yuqlid/MotorBench_board/stp/c-282834-8-c-3d.stp

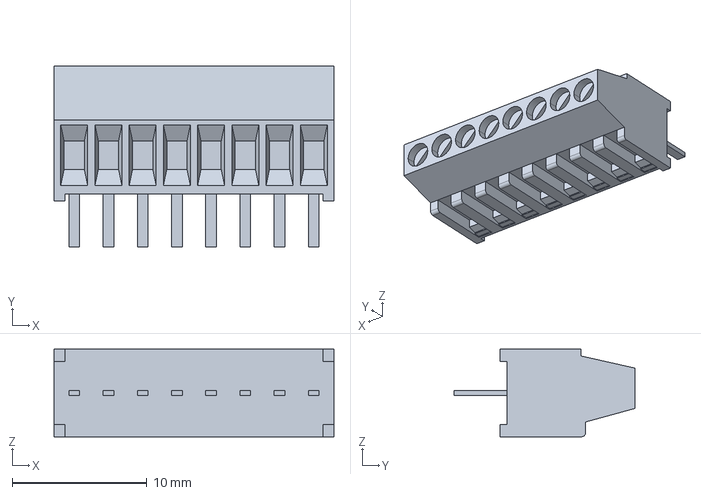
[picture p1: CAD file, 2020-02-05]
stp/c-282834-8-c-3d.stp
20.8 x 13.4 x 6.50 mm
