yuqlid/MotorBench_board/Encoder_check.kicad_pcb

## KiCad design Encoder_check.kicad_pcb (2020-04-29)

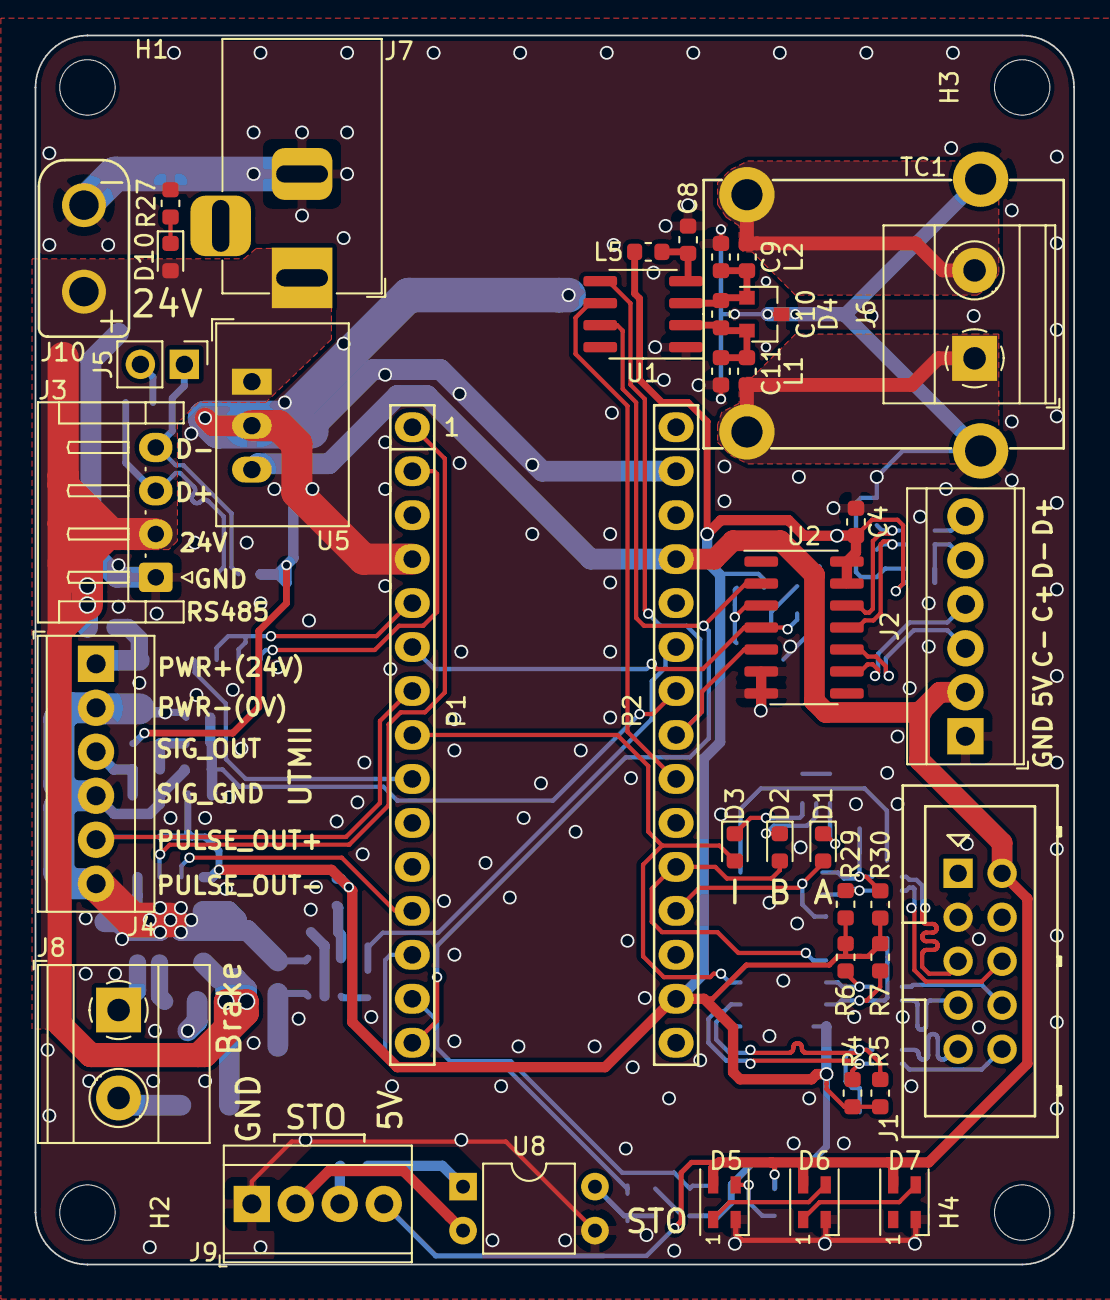
[picture p2: board Encoder_check.kicad_pcb from above]

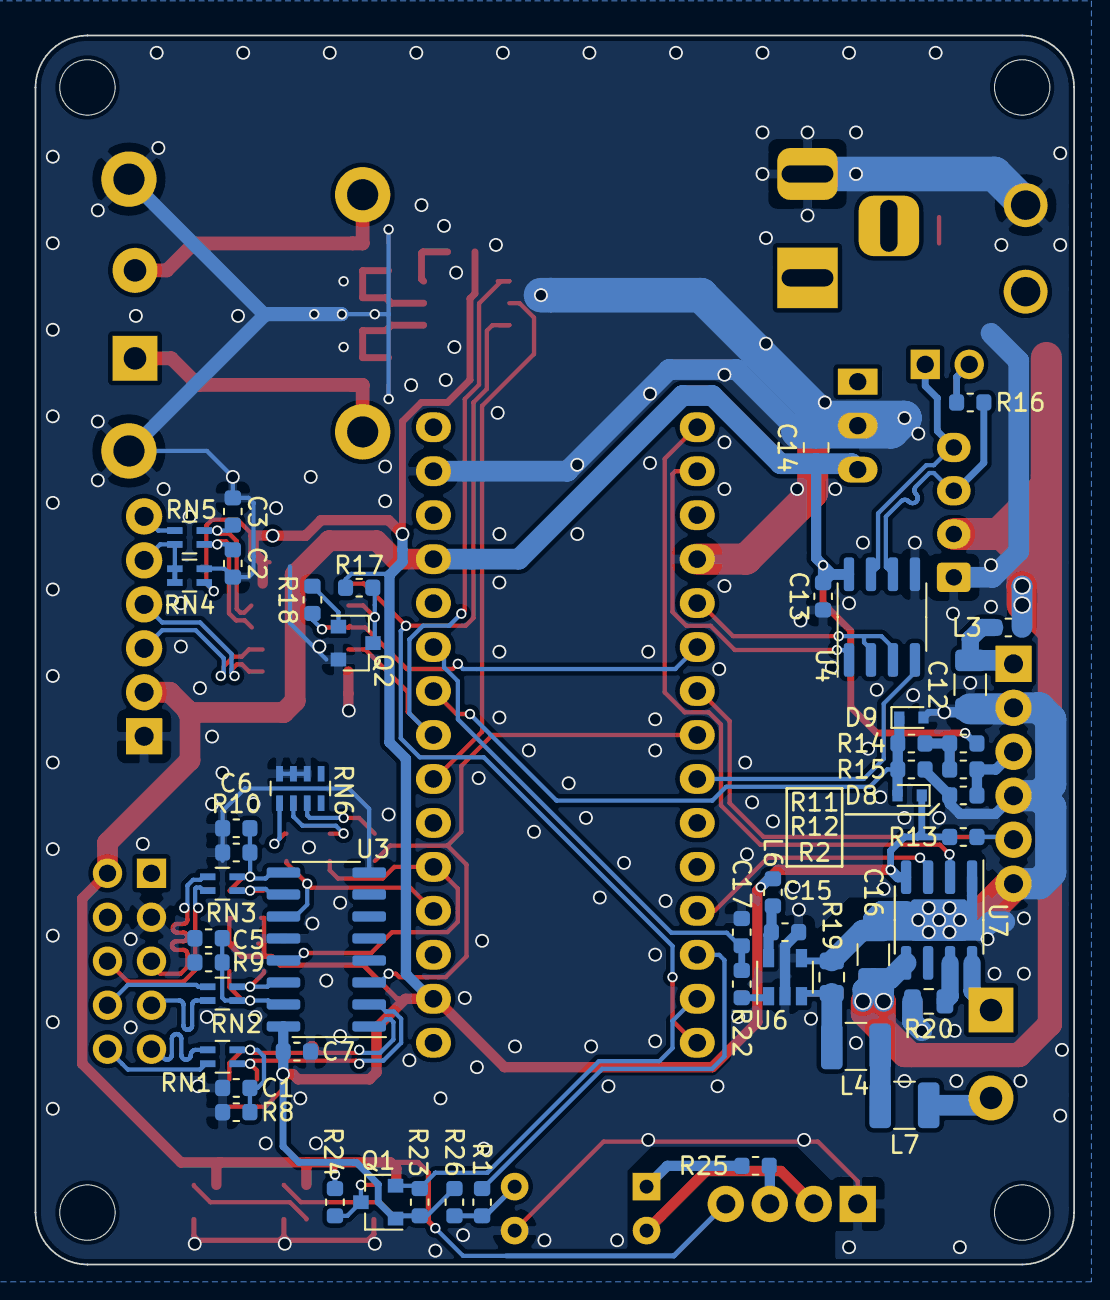
[picture p3: board Encoder_check.kicad_pcb from below]

Board: 2 copper layers, 60.0 x 71.0 mm, 94 parts (50 on the bottom side), 71 nets.

Parts:
C1, C2, C3, C5, C6: 220p; C_0603_1608Metric
C4, C7, C8, C13, C15, C17: 0.1u; C_0603_1608Metric
C9, C11: DNP; C_0603_1608Metric
C10: 10n; C_0603_1608Metric
C12: C; C_1206_3216Metric
C14: 3.3u; C_0805_2012Metric
C16: 1u; C_1206_3216Metric
D1, D2, D3, D10: LED; LED_0603_1608Metric
D4: D_TVS_x2_AAC; SOT-23
D5, D6, D7: SK6805; LED_SK6805_PLCC4_2.4x2.7mm_P1.3mm
D8, D9: D; D_SOD-523
H1, H2, H3, H4: MountingHole; MountingHole_3.2mm_M3
J1: Conn_02x05_Odd_Even; Multicomp_MC9A12-1034_2x05_P2.54mm_Vertical
J2, J4: Screw_Terminal_01x06; TerminalBlock_TE_282834-6_1x06_P2.54mm_Horizontal
J3: Conn_01x04; JST_EH_S4B-EH_1x04_P2.50mm_Horizontal
J5: Conn_01x02; PinHeader_1x02_P2.54mm_Vertical
J6, J8: Screw_Terminal_01x02; TerminalBlock_Phoenix_MKDS-1,5-2-5.08_1x02_P5.08mm_Horizont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
J7: Barrel_Jack_Switch; BarrelJack_Horizontal
J9: Screw_Terminal_01x04; TerminalBlock_TE_282834-4_1x04_P2.54mm_Horizontal
J10: Conn_01x02; XT30PB
L1, L2, L3, L5, L6: L; L_0603_1608Metric
L4, L7: L; L_1210_3225Metric
P1: Digital; Socket_Strip_Arduino_1x15
P2: Analog; Socket_Strip_Arduino_1x15
Q1, Q2: BSS138; SOT-23
R1, R13, R18, R25: 1k; R_0603_1608Metric
R2, R4, R6, R11, R12, R14, R15, R17, R23, R24, R26, R29: 10k; R_0603_1608Metric
R5, R7, R8, R9, R10, R27, R30: 20k; R_0603_1608Metric
R16: 120; R_0603_1608Metric
R19: 0.05; L_0805_2012Metric
R20: 0; L_0805_2012Metric
R22: 100; L_0603_1608Metric
RN1, RN2, RN3, RN5: 150; R_Array_Concave_2x0603
RN4: 4.7k; R_Array_Concave_2x0603
RN6: 1k; R_Array_Concave_4x0603
TC1: Thermocouple_PCB; Omega_PCC-SMP_1x2_P13.70mm_Horizontal
U1: MAX31855KASA; SOIC-8_3.9x4.9mm_P1.27mm
U2: ISL83491; SOIC-14_3.9x8.7mm_P1.27mm
U3: AM26LV32xD; SOIC-16_3.9x9.9mm_P1.27mm
U4: ST485BDR; SOIC-8_3.9x4.9mm_P1.27mm
U5: M78AR05-1; Converter_DCDC_MINIMAX_M78AR05-1_THT
U6: INA180A; SOT-23-5
U7: A4953_LJ; SOIC-8-1EP_3.9x4.9mm_P1.27mm_EP2.41x3.3mm
U8: TLP785; DIP-4_W7.62mm

Connections:
+3V3: C4.1, C7.1, D8.1, L5.1, L6.1, P2.14, Q1.1, R4.1, R5.1, R6.1, R7.1, R13.2, R17.2, R23.1, R26.1, R29.1, R30.1, RN4.3, U2.13, U2.14, U3.16, U7.4
+5V: C13.1, C14.1, D5.4, D6.4, D7.4, J1.2, J2.2, J9.4, P2.4, R11.1, R24.1, U4.8, U5.3
+24V: C16.1, D10.2, J3.2, J7.1, J10.1, L3.2, U5.1, U7.5
/0(Rx): P1.2, U4.1
/1(Tx): P1.1, U7.2
/2: P1.5, U4.2, U4.3
/3(**): P1.6, R18.1, U2.4
/4: J4.5, P1.7, R13.1
/5(**): D3.2, P1.8, U3.3
/6(**): P1.9, U4.4
/9(**): P1.12, U7.3
/10(**/SS): P1.13, R1.1
/11(**/MOSI): P1.14, Q1.2, R23.2
/12(MISO): P1.15, U1.7, U2.2
/A0: D1.2, P2.12, U3.11
/A1: D2.2, P2.11, U3.13
/A3: P2.9, U1.6
/A4: P2.8, U1.5, U2.5
/A5: D8.2, D9.1, P2.7, R14.1, R15.2
/A6: C17.1, P2.6, R22.1
/Reset: P1.3, P2.3
/brake/brake_+: J8.1, U7.8
/brake/brake_-: J8.2, L7.1
/inc_encoder/A+: J1.6, RN3.4
/inc_encoder/A-: J1.5, RN3.3
/inc_encoder/A_+: R29.2, RN3.1, U3.10
/inc_encoder/A_-: C6.1, R10.1, R30.2, RN3.2, U3.9
/inc_encoder/B+: J1.8, RN2.3
/inc_encoder/B-: J1.7, RN2.4
/inc_encoder/B_+: R6.2, RN2.2, U3.14
/inc_encoder/B_-: C5.1, R7.2, R9.1, RN2.1, U3.15
/inc_encoder/I+: J1.10, RN1.4
/inc_encoder/I-: J1.9, RN1.3
/inc_encoder/I_+: R4.2, RN1.1, U3.2
/inc_encoder/I_-: C1.1, R5.2, R8.1, RN1.2, U3.1
/rs485/RS485_+: J3.3, R16.2, U4.6
/rs485/RS485_-: J3.4, J5.1, U4.7
/ssi_encoder/C_+: J2.4, U2.9
/ssi_encoder/C_-: J2.3, U2.10
/ssi_encoder/D_+: J2.6, RN5.3
/ssi_encoder/D_-: J2.5, RN4.1, RN4.2, RN5.4
/ssi_encoder/Dout_+: C3.1, RN5.2, U2.12
/ssi_encoder/Dout_-: C2.1, RN5.1, U2.11
/thermocouple/T+: J6.2, L2.1, TC1.1
/thermocouple/T-: J6.1, L1.1, TC1.2
/utm/PWR+(24V): C12.1, J4.1, L3.1
/utm/SIG_OUT: J4.3, R2.2, R12.1
GND: C1.2, C2.2, C3.2, C4.2, C5.2, C6.2, C7.2, C8.2, C9.1, C11.2, C12.2, C13.2, C14.2, C15.2, C16.2, C17.2, D4.3, D5.2, D6.2, D7.2, D9.2, J1.3, J2.1, J3.1, J4.2, J4.4, J4.6, J7.2, J9.1, J10.2, P1.4, P2.2, Q2.2, R2.1, R8.2, R9.2, R10.2, R15.1, R19.2, R20.2, R27.2, RN4.4, RN6.6, RN6.7, RN6.8, TC1.3, U1.1, U2.6, U2.7, U3.4, U3.8, U3.12, U4.5, U5.2, U6.2, U6.4, U7.1, U7.9, U8.3
unnamed: C8.1, L5.2, U1.4
unnamed: C9.2, C10.1, D4.1, L2.2, U1.3
unnamed: C10.2, C11.1, D4.2, L1.2, U1.2
unnamed: C15.1, L6.2, U6.5
unnamed: D1.1, RN6.1
unnamed: D2.1, RN6.2
unnamed: D3.1, RN6.3
unnamed: D5.1, D6.3
unnamed: D5.3, Q1.3, R24.2
unnamed: D6.1, D7.3
unnamed: D10.1, R27.1
unnamed: J5.2, R16.1
unnamed: J9.2, U8.2
unnamed: J9.3, R25.2
unnamed: L4.1, L7.2
unnamed: L4.2, R19.1, U6.3
unnamed: Q2.1, R18.2
unnamed: Q2.3, R17.1, U2.3
unnamed: R1.2, R26.2, U8.4
unnamed: R11.2, R12.2, R14.2
unnamed: R20.1, U7.7
unnamed: R22.2, U6.1
unnamed: R25.1, U8.1
