yuqlid/MotorBench_board/(commit log)

2020-02-13 これで発注
    [Encoder_check.kicad_pcb, Encoder_check.sch, brake.sch]
2020-02-22 SPIにつなぐデバイスの電圧が違ったため設計ミスが判明。 これを修正した
    [Encoder_check.kicad_pcb, Encoder_check.sch, brake.sch, inc_encoder.sch, rs485.sch, ssi_encoder.sch, thermocouple.sch, utm.sch]
2020-02-23 見つけた設計ミスを全部反映
    [Encoder_check.kicad_pcb, Encoder_check.sch, brake.sch, inc_encoder.sch, rs485.sch, ssi_encoder.sch, thermocouple.sch, utm.sch]
2020-02-25 部品のパラメータ未記入部分があったので追記
    [Encoder_check.kicad_pcb, Encoder_check.sch, brake.sch]
2020-03-28 エンコーダの配線ミスってた
    [Encoder_check.kicad_pcb, Encoder_check.sch, inc_encoder.sch]
2020-03-29 レシーバの出力が有効になっていないとうアホなミスを修正
    [Encoder_check.kicad_pcb, inc_encoder.sch]
2020-04-04 設計修正
    [Encoder_check.kicad_pcb, Encoder_check.sch, brake.sch, utm.sch]
2020-04-29 シルクミスやらかした
    [Encoder_check.kicad_pcb]
